kwyoke/Y2-18-19---Musicap/README.md

# Y2-18-19---Musicap
Created a prototype musical instrument for the physically handicapped in the form of a cap and a mouthpiece that can be played by moving the head and blowing into the mouthpiece.

See demo: https://www.youtube.com/watch?v=UX_DPvC_nr0&feature=youtu.be

See project website: https://eddyturner98.wixsite.com/musicap
